HandHeldLegend/RetroGlow-GBA-SP/HW/retroglow_sp.kicad_pcb

## KiCad design HW/retroglow_sp.kicad_pcb (2024-11-22)

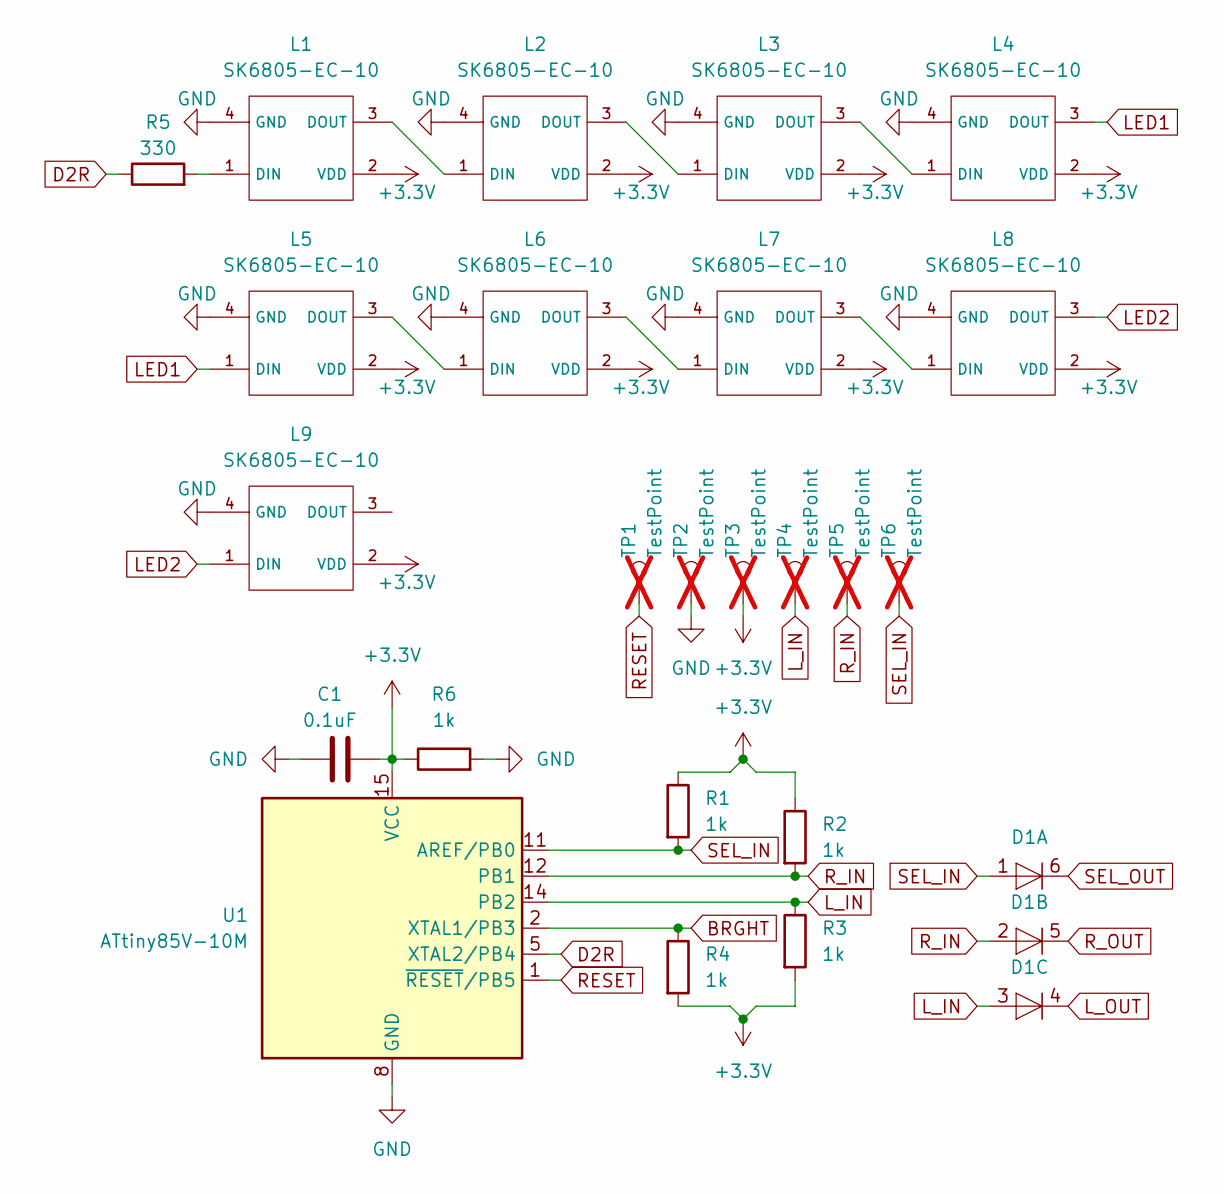
[picture p1: schematic retroglow_sp.kicad_sch]

Parts:
C1: 0.1uF; C_0805_2012Metric; MPN C0805B104K500NT
D1: BAS16VY,115; SOT-363_SC-70-6; MPN BAS16VY,115
L1, L2, L3, L4, L5, L6, L7, L8, L9: SK6805-EC-10; MPN SK6805-EC-10
R1, R2, R3, R4, R6: 1k; R_0402_1005Metric; MPN 0402WGF1001TCE
R5: 330; R_0402_1005Metric; MPN 0402WGF3300TCE
TP1, TP2, TP3, TP4, TP5, TP6: TestPoint; TestPoint_Pad_D1.0mm; not fitted
U1: ATtiny85V-10M; QFN-20-1EP_4x4mm_P0.5mm_EP2.6x2.6mm; MPN ATtiny85V-10M

Connections:
+3.3V: C1.2, L1.2 (VDD), L2.2 (VDD), L3.2 (VDD), L4.2 (VDD), L5.2 (VDD), L6.2 (VDD), L7.2 (VDD), L8.2 (VDD), L9.2 (VDD), R1.1, R2.1, R3.2, R4.2, R6.1, TP3.1, U1.15 (VCC)
BRGHT: R4.1, U1.2 (XTAL1/PB3)
D2R: R5.1, U1.5 (XTAL2/PB4)
GND: C1.1, L1.4 (GND), L2.4 (GND), L3.4 (GND), L4.4 (GND), L5.4 (GND), L6.4 (GND), L7.4 (GND), L8.4 (GND), L9.4 (GND), R6.2, TP2.1, U1.8 (GND), U1.21 (GND)
LED1: L4.3 (DOUT), L5.1 (DIN)
LED2: L8.3 (DOUT), L9.1 (DIN)
L_IN: D1.3 (A), R3.1, TP4.1, U1.14 (PB2)
L_OUT: D1.4 (K)
unnamed: L1.1 (DIN), R5.2
unnamed: L1.3 (DOUT), L2.1 (DIN)
unnamed: L2.3 (DOUT), L3.1 (DIN)
unnamed: L3.3 (DOUT), L4.1 (DIN)
unnamed: L5.3 (DOUT), L6.1 (DIN)
unnamed: L6.3 (DOUT), L7.1 (DIN)
unnamed: L7.3 (DOUT), L8.1 (DIN)
RESET: TP1.1, U1.1 (~RESET/PB5)
R_IN: D1.2 (A), R2.2, TP5.1, U1.12 (PB1)
R_OUT: D1.5 (K)
SEL_IN: D1.1 (A), R1.2, TP6.1, U1.11 (AREF/PB0)
SEL_OUT: D1.6 (K)

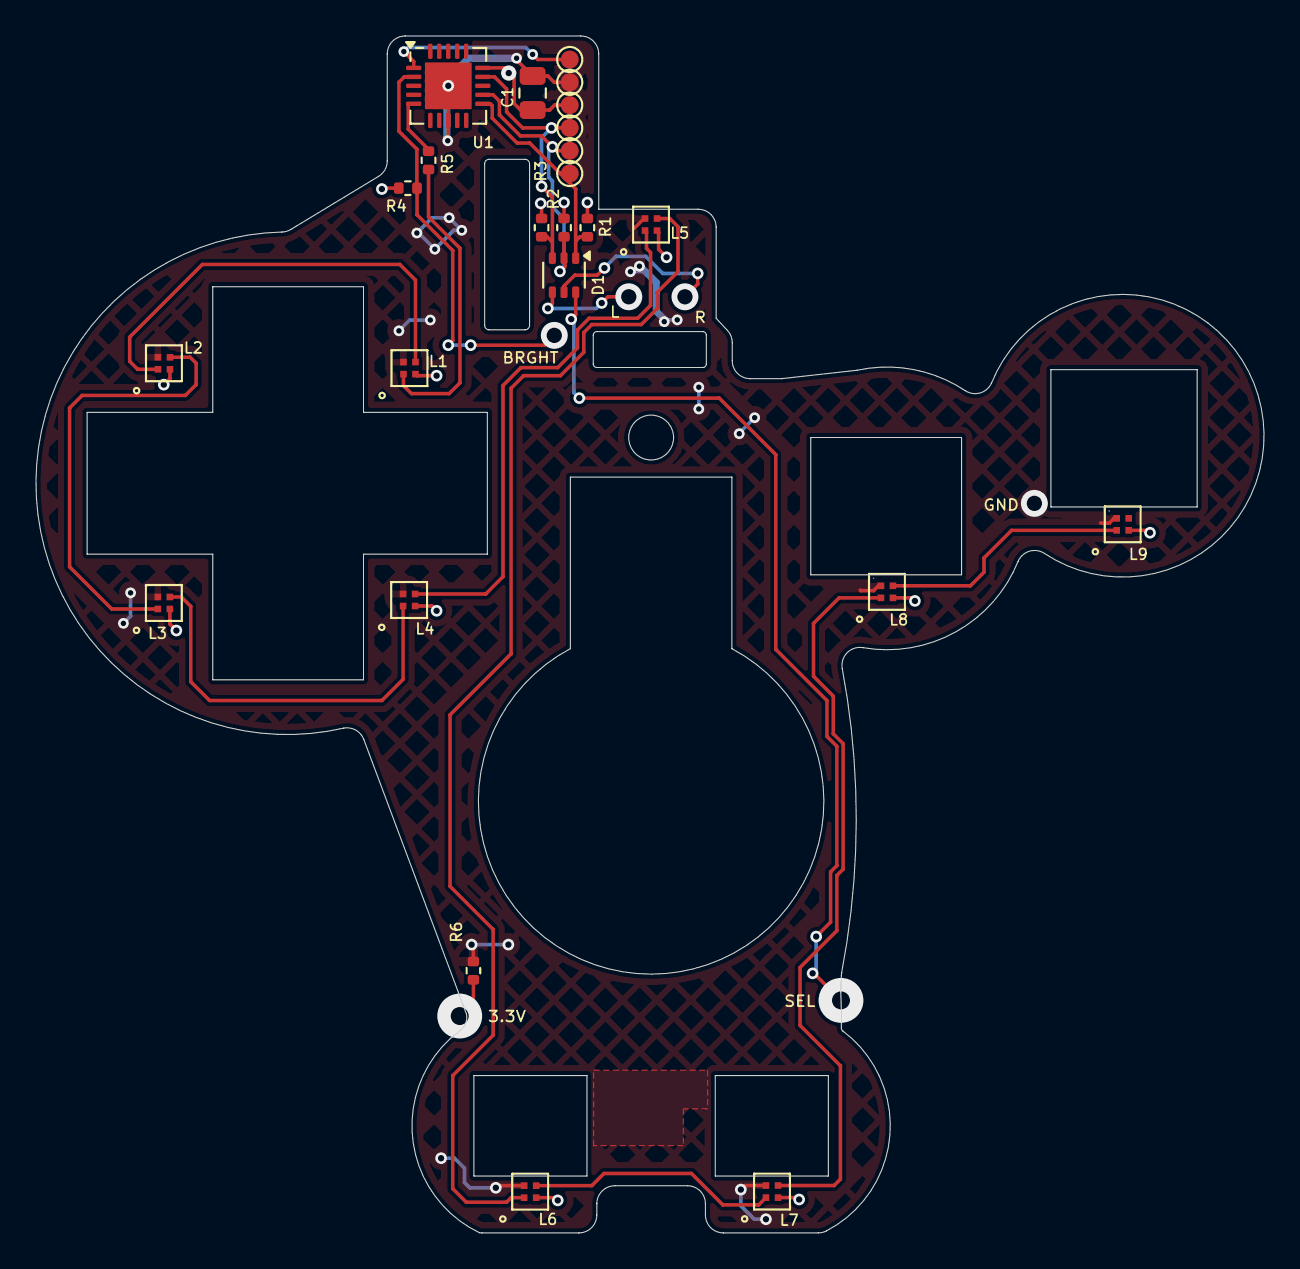
[picture p2: board retroglow_sp.kicad_pcb from above]

Board: 2 copper layers, 68.4 x 66.7 mm, 24 parts (0 on the bottom side), 17 nets.
