HandHeldLegend/RetroGlow-GBA-SP/(commit log)

2022-04-19 Added brightness control option
    Allows for brightness control when using housings that do not have a brightness button.
2022-04-21 Fixed saving bug
    - Added auto-save brightness whenever that option is changed
    - Fixed bug where colors would not save in some circumstances.
    [RetroGlowSP.ino]
2024-11-22 Updates to PCB
    [retroglow_sp-B_Cu.gbr, retroglow_sp-B_Mask.gbr, retroglow_sp-B_Paste.gbr, retroglow_sp-B_Silkscreen.gbr, retroglow_sp-Edge_Cuts.gbr, retroglow_sp-F_Cu.gbr, retroglow_sp-F_Mask.gbr, retroglow_sp-F_Paste.gbr]
